Plokkke/sauter-marapi-esphome/hardware/linap/radiator-controller-linap-3d.png

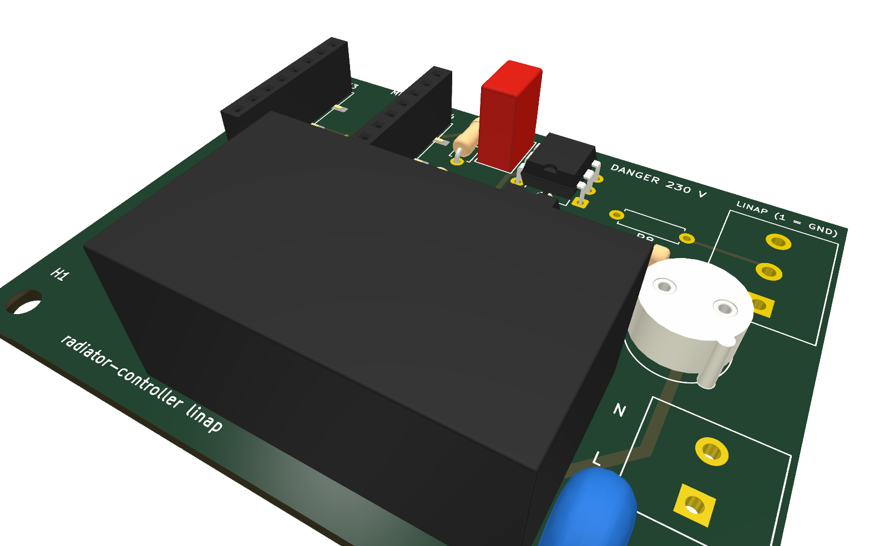
hardware/linap/radiator-controller-linap-3d.png
