Plokkke/sauter-marapi-esphome/hardware/linap/radiator-controller-linap-bottom.png

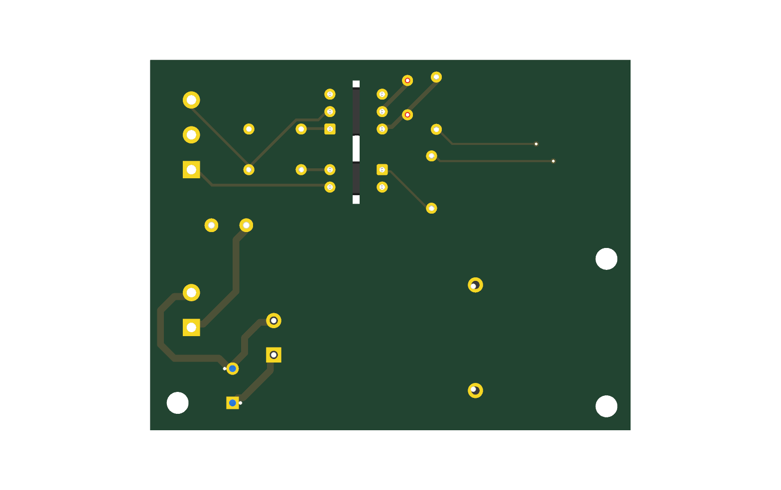
hardware/linap/radiator-controller-linap-bottom.png
