Plokkke/sauter-marapi-esphome/hardware/linap/radiator-controller-linap-top.png

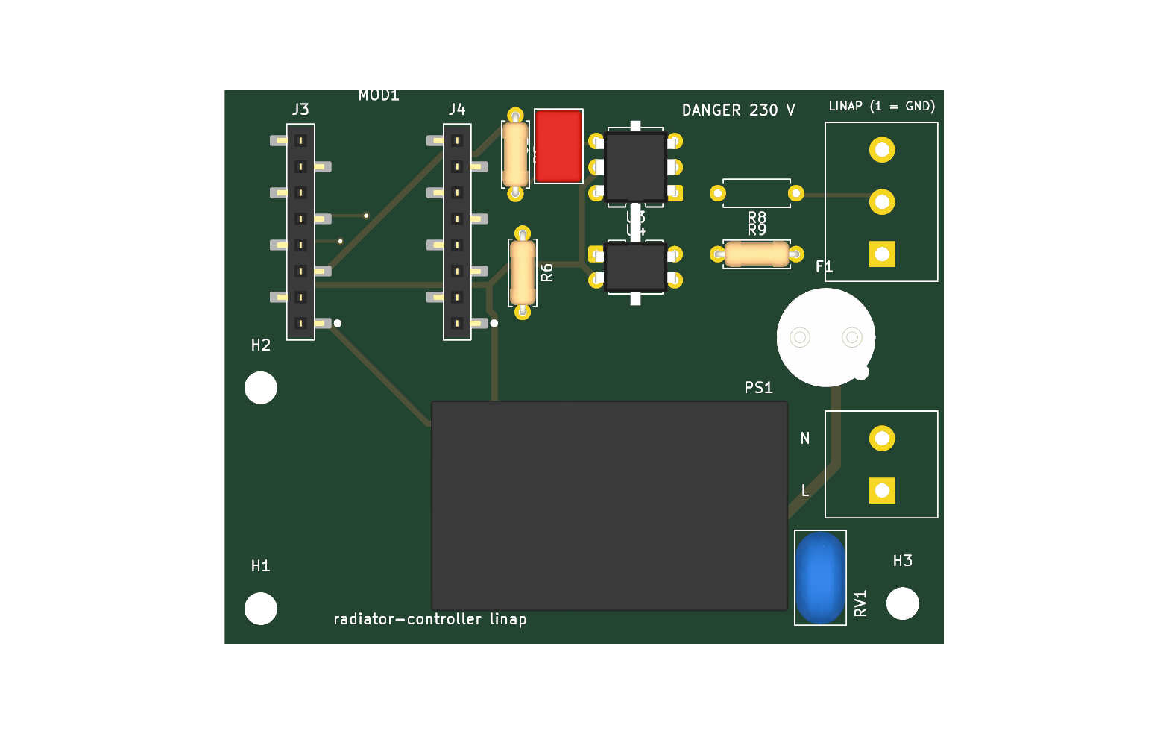
hardware/linap/radiator-controller-linap-top.png
