Plokkke/sauter-marapi-esphome/hardware/radiator-controller-bottom.png

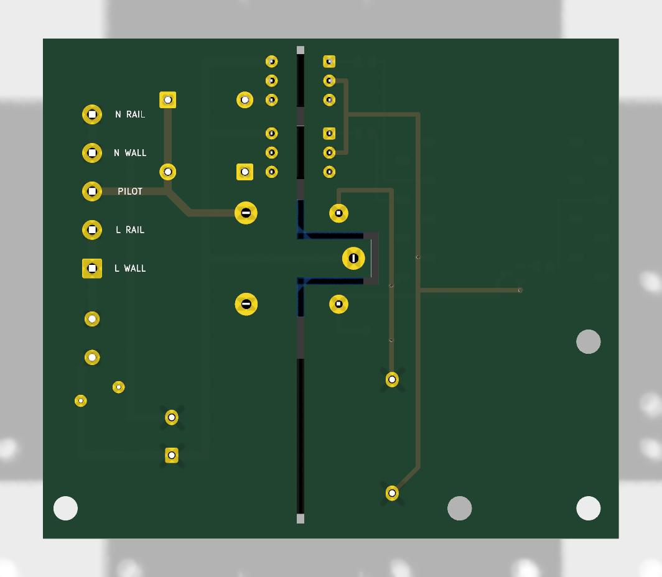
hardware/radiator-controller-bottom.png
