Plokkke/sauter-marapi-esphome/hardware/radiator-controller-top.png

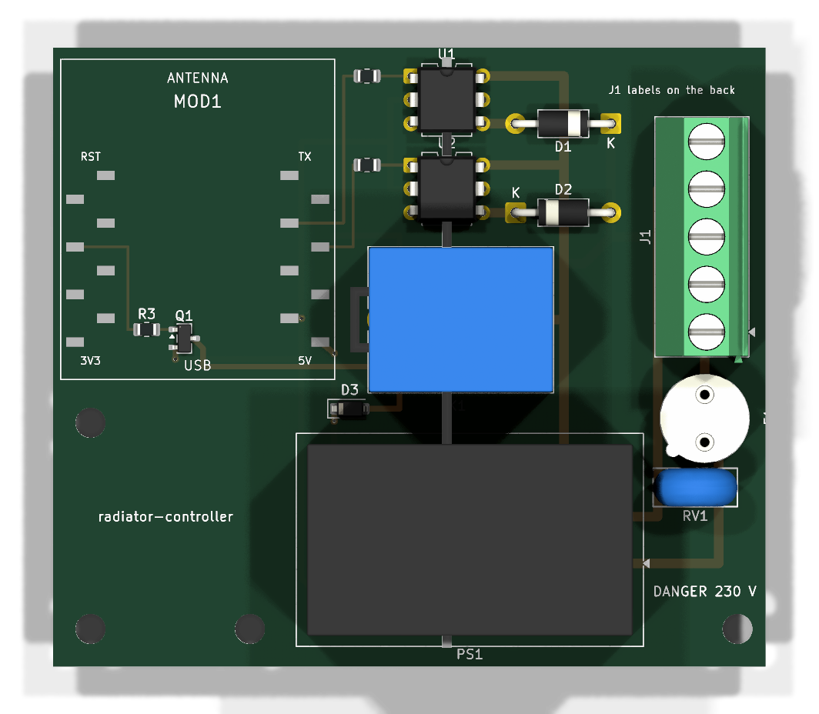
hardware/radiator-controller-top.png
