Plokkke/sauter-marapi-esphome/knowledge/photos/command-board-keys.jpg

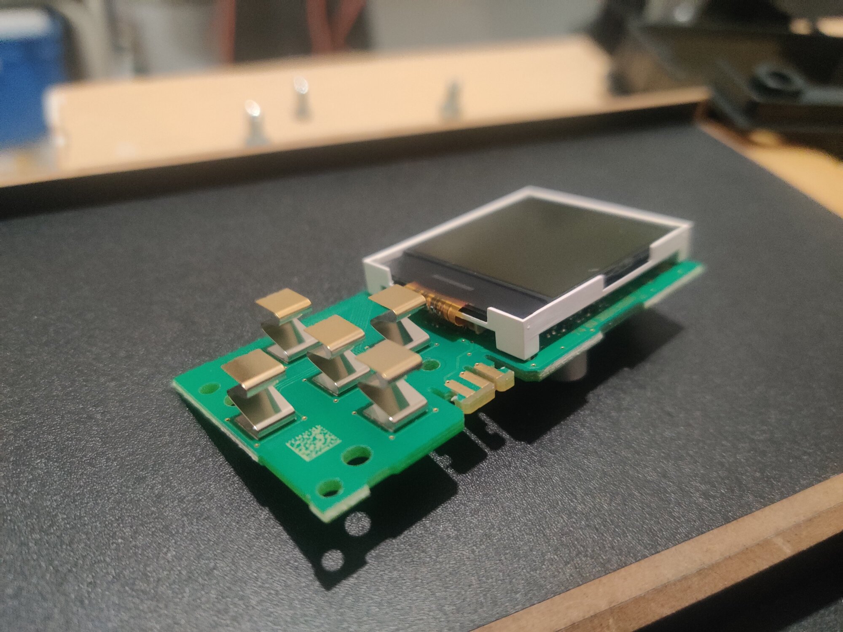
knowledge/photos/command-board-keys.jpg
