Plokkke/sauter-marapi-esphome/hardware/linap/radiator-controller-linap.step

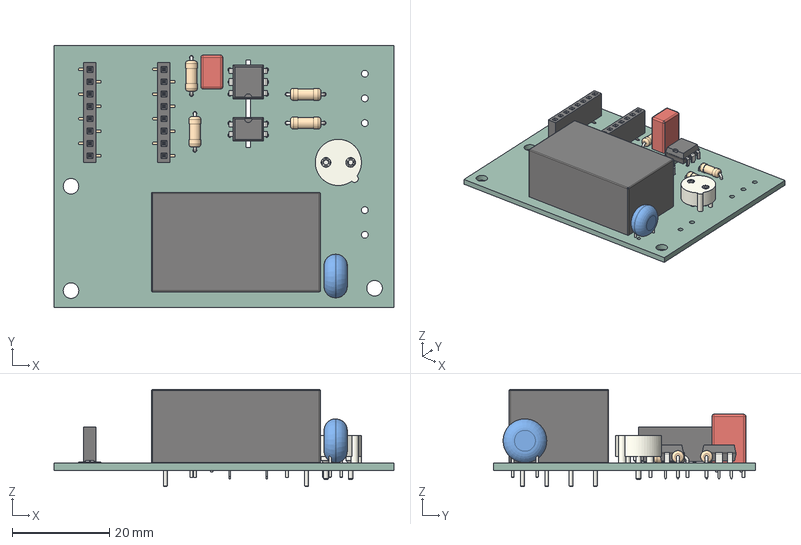
[picture p11: CAD file, 2026-11-09]
hardware/linap/radiator-controller-linap.step
70.0 x 54.0 x 20.0 mm
C_Rect_L70mm_W45mm_P500mm
PinSocket_1x08_P2.54mm_Vertical_SMD_Pin1Left x 2
R_Axial_DIN0207_L63mm_D25mm_P762mm_Horizontal x 4
RV_Disc_D9mm_W48mm_P5mm
Converter_ACDC_Hi-Link_HLK-PMxx
DIP-4_W7.62mm
A_Littelfuse_No560_No460
DIP-6_W7.62mm
radiator-controller-linap_PCB
