Plokkke/sauter-marapi-esphome/hardware/pilot-wire/radiator-controller-pilot-wire.step

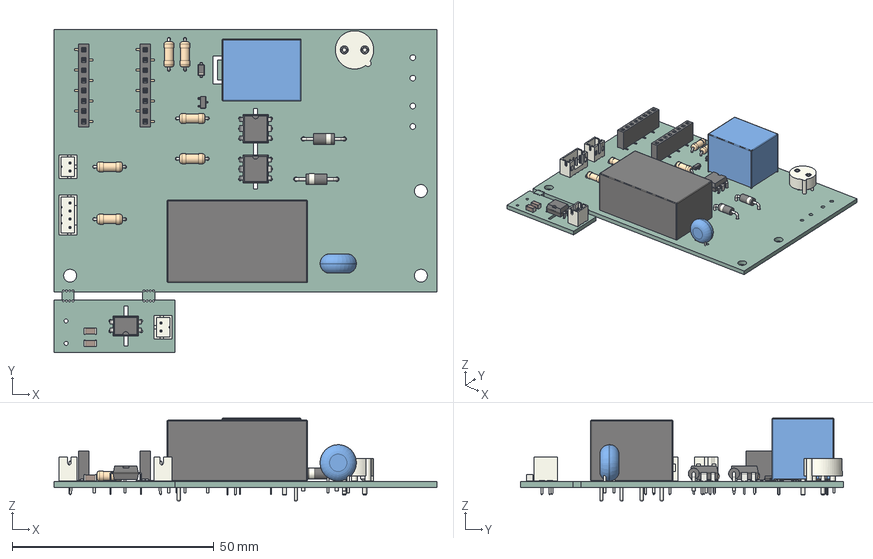
[picture p12: CAD file, 2026-11-09]
hardware/pilot-wire/radiator-controller-pilot-wire.step
95.0 x 80.0 x 20.5 mm
R_Axial_DIN0207_L63mm_D25mm_P762mm_Horizontal x 6
DIP-6_W7.62mm x 2
RV_Disc_D9mm_W48mm_P5mm
D_DO-41_SOD81_P10.16mm_Horizontal x 2
JST_B2B_PH_K x 2
PinSocket_1x08_P2.54mm_Vertical_SMD_Pin1Left x 2
JST_B4B_PH_K
Converter_ACDC_Hi-Link_HLK-PMxx
D_SOD-123
C_1206_3216Metric x 2
A_Littelfuse_No560_No460
SOT-23
Relay_SPDT_SANYOU_SRD_Series_Form_C
DIP-4_W7.62mm
radiator-controller-pilot-wire_PCB
