Plokkke/sauter-marapi-esphome/hardware/radiator-controller.step

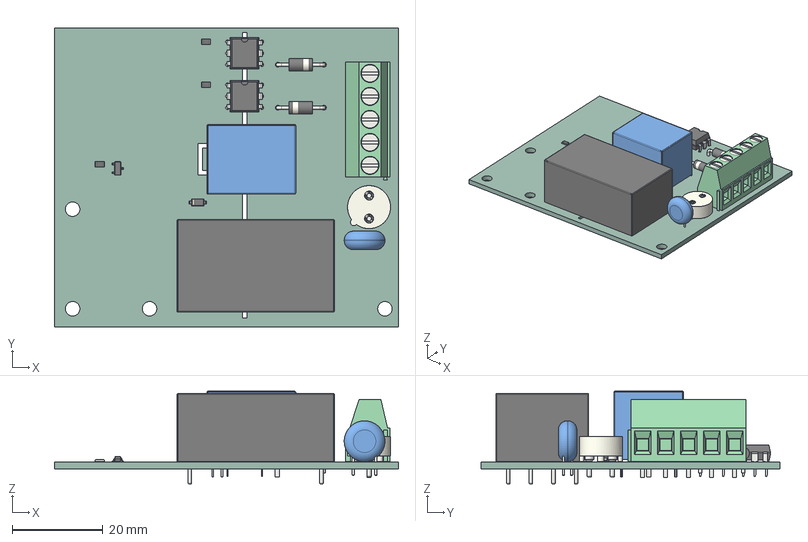
[picture p13: CAD file, 2026-10-26]
hardware/radiator-controller.step
76.0 x 66.0 x 20.5 mm
D_DO-41_SOD81_P10.16mm_Horizontal x 2
R_0805_2012Metric x 3
A_Littelfuse_No560_No460
D_SOD-123
Relay_SPDT_SANYOU_SRD_Series_Form_C
DIP-6_W7.62mm x 2
SOT-23
RV_Disc_D9mm_W41mm_P5mm
TerminalBlock_Phoenix_MKDS-1,5-5-5.08_1x05_P5.08mm_Horizontal
Converter_ACDC_Hi-Link_HLK-PMxx
radiator-controller_PCB
