Plokkke/sauter-marapi-esphome/hardware/pilot-wire/radiator-controller-pilot-wire.kicad_pcb

## KiCad design hardware/pilot-wire/radiator-controller-pilot-wire.kicad_pcb (2026-11-09)

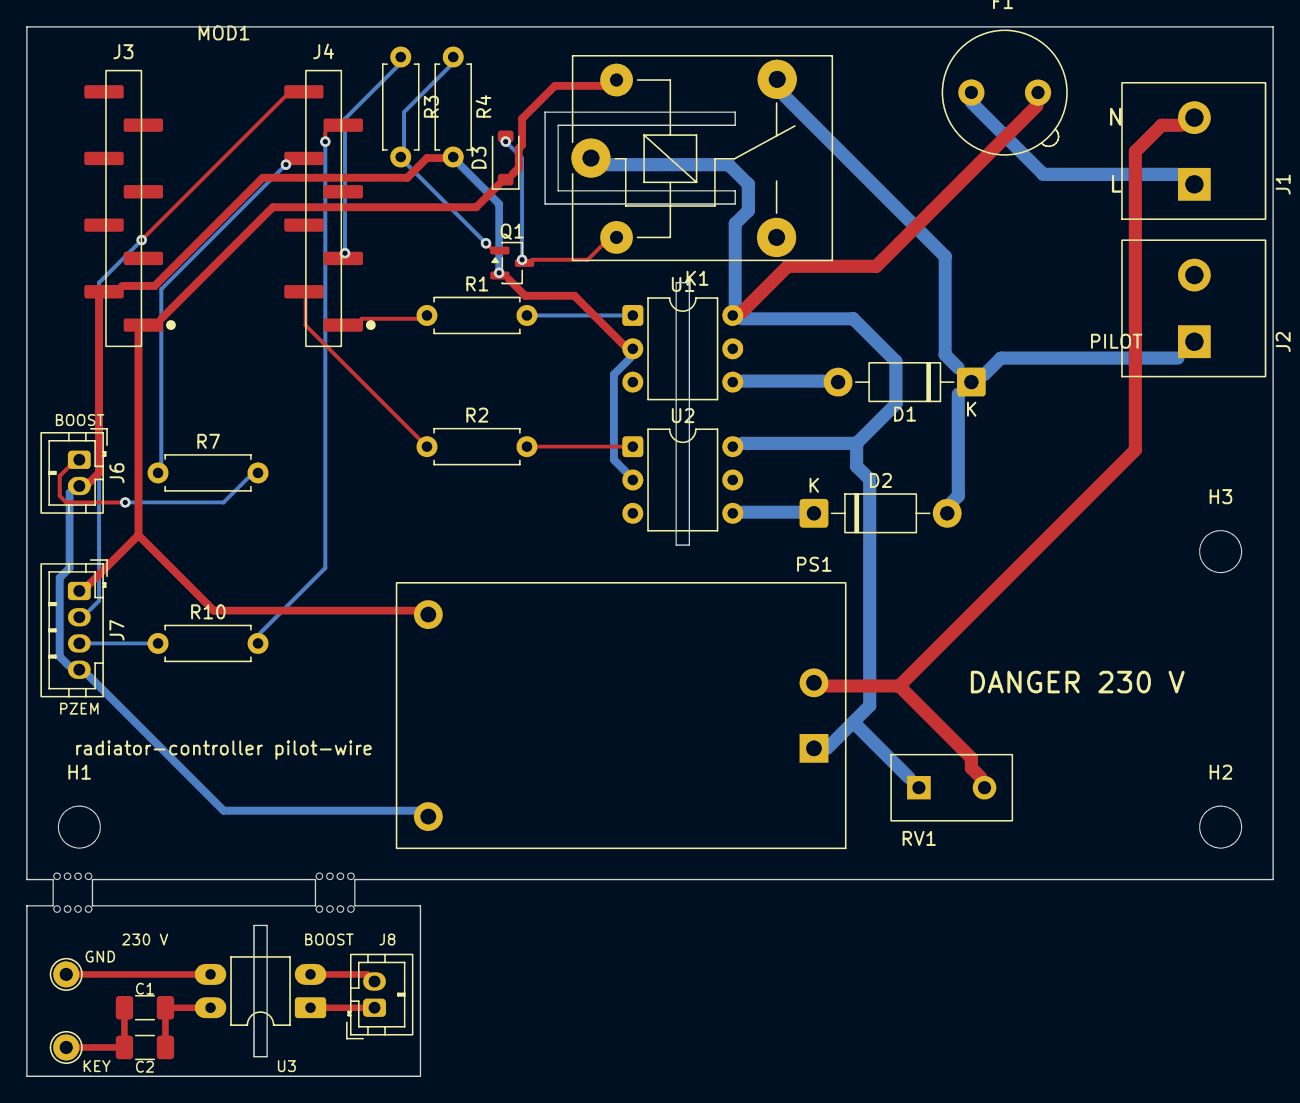
[picture p14: board radiator-controller-pilot-wire.kicad_pcb from above]

Board: 2 copper layers, 95.0 x 80.0 mm, 34 parts (0 on the bottom side), 25 nets.

Parts:
C1, C2: 10-100p C0G; C_1206_3216Metric_Pad1.33x1.80mm_HandSolder
D1, D2: 1N4007; D_DO-41_SOD81_P10.16mm_Horizontal
D3: 1N4148W; D_SOD-123
F1: TR5 holder + T1A fuse; Fuseholder_TR5_Littelfuse_No560_No460
H1, H2, H3: MountingHole_3.2mm_M3
J1: KF128-5.08 (L, N); TerminalBlock_Kefa_KF128-5.08_1x02
J2: KF128-5.08 (pilot wire); TerminalBlock_Kefa_KF128-5.08_1x02
J3, J4: Socket 1x8 SMD; PinSocket_1x08_P2.54mm_SMD_HX-ZQ
J6: JST PH 2 (Boost photoMOS LED); JST_PH_B2B-PH-K_1x02_P2.00mm_Vertical_Drill0.9
J7: JST PH 4 (PZEM-004T v3: 5V RX TX GND); JST_PH_B4B-PH-K_1x04_P2.00mm_Vertical_Drill0.9
J8: JST PH 2 (from J6); JST_PH_B2B-PH-K_1x02_P2.00mm_Vertical_Drill0.9
K1: SRD-05VDC-SL-C; Relay_SPDT_SANYOU_SRD_Series_Form_C
MB1, MB2: Breakaway_MouseBites_3mm
MOD1: ESP32-C3 super mini; ESP32-C3_SuperMini_Outline
PS1: HLK-PM01; Converter_ACDC_HLK-PM01
Q1: MMBT2222A; SOT-23
R1, R2, R7: 220; R_Axial_DIN0207_L6.3mm_D2.5mm_P7.62mm_Horizontal
R3, R10: 1k; R_Axial_DIN0207_L6.3mm_D2.5mm_P7.62mm_Horizontal
R4: 10k; R_Axial_DIN0207_L6.3mm_D2.5mm_P7.62mm_Horizontal
RV1: MOV-07D431K (275VAC); RV_Disc_D9mm_W4.8mm_P5mm_Inline
TP1: KEY; TestPoint_THTPad_D2.0mm_Drill1.0mm
TP2: CTRL GND; TestPoint_THTPad_D2.0mm_Drill1.0mm
U1, U2: MOC3043M; DIP-6_W7.62mm
U3: photoMOS; DIP-4_W7.62mm_LongPads

Connections:
+5V: D3.1, J3.1, J7.1, K1.5, PS1.4
/GPIO5: J4.1, R1.1
/GPIO6: J4.2, R2.1
/GPIO7: J4.3, R3.1
/GPIO10: J4.6, R7.1
/GPIO20: J4.7, R10.2
/GPIO21: J4.8, J7.2
/KEY: C1.2, C2.2, TP1.1
/KEY_SW: C1.1, C2.1, U3.4
/L: F1.1, J1.1
/LINAP_GND: TP2.1, U3.3
/L_FUSED: F1.2, K1.1, PS1.1, RV1.1, U1.6, U2.6
/N: J1.2, PS1.2, RV1.2
/PILOT_WIRE: D1.1, D2.2, J2.1, K1.4
/U1_OUT: D1.2, U1.4
/U2_OUT: D2.1, U2.4
GND: J3.2, J6.2, J7.4, PS1.3, Q1.2, R4.2, U1.2, U2.2
unnamed: D3.2, K1.2, Q1.3
unnamed: J6.1, R7.2
unnamed: J7.3, R10.1
unnamed: J8.1, U3.1
unnamed: J8.2, U3.2
unnamed: Q1.1, R3.2, R4.1
unnamed: R1.2, U1.1
unnamed: R2.2, U2.1
