Plokkke/sauter-marapi-esphome/hardware/linap/radiator-controller-linap.kicad_pcb

## KiCad design hardware/linap/radiator-controller-linap.kicad_pcb (2026-11-09)

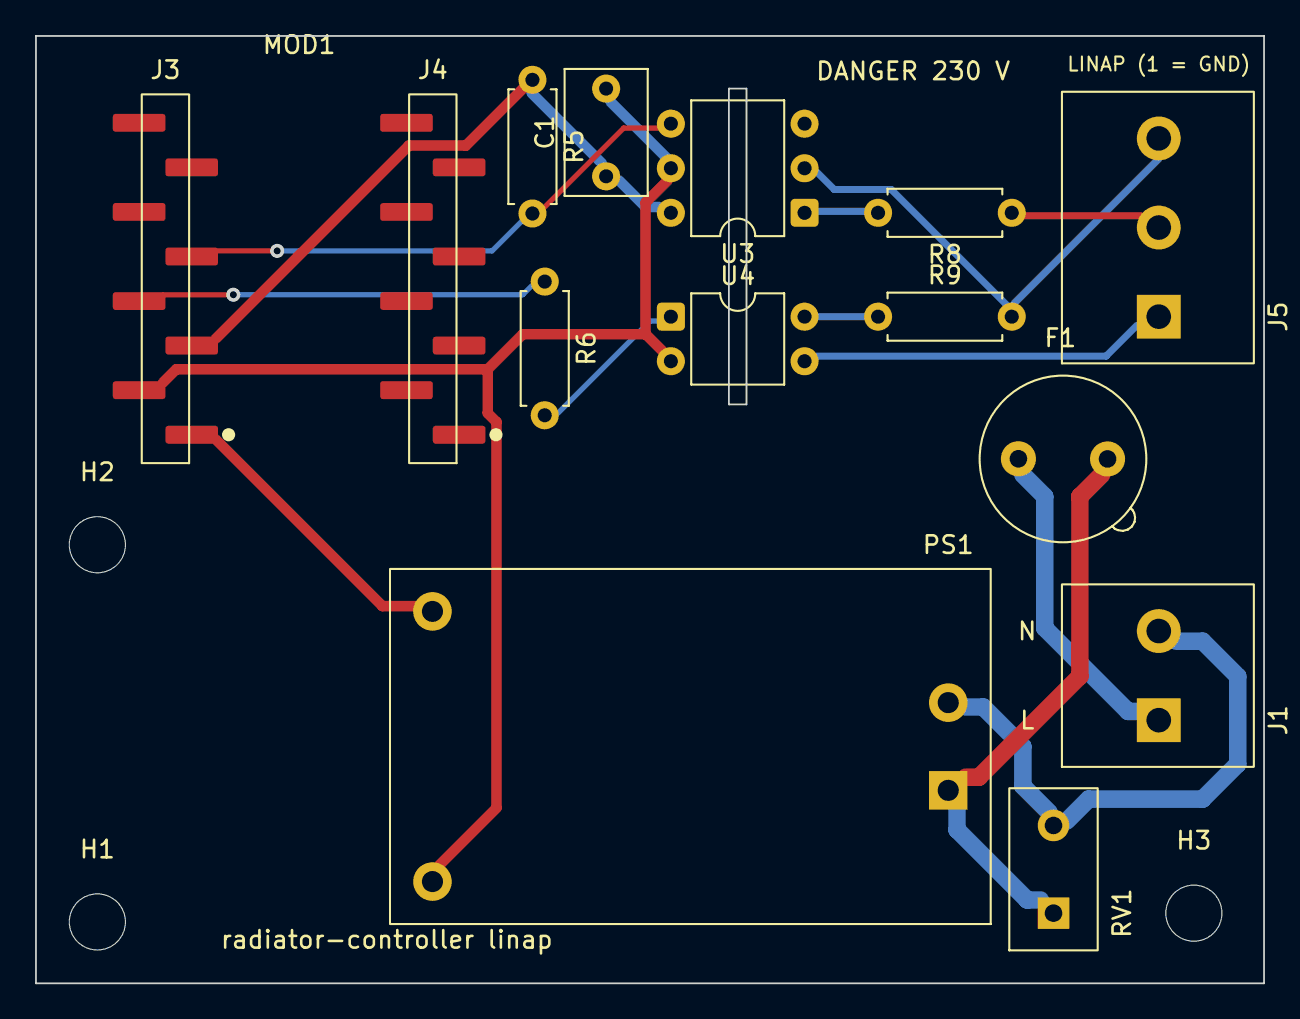
[picture p15: board radiator-controller-linap.kicad_pcb from above]

Board: 2 copper layers, 70.0 x 54.0 mm, 18 parts (0 on the bottom side), 14 nets.

Parts:
C1: 100n; C_Rect_L7.0mm_W4.5mm_P5.00mm
F1: TR5 holder + T1A fuse; Fuseholder_TR5_Littelfuse_No560_No460
H1, H2, H3: MountingHole_3.2mm_M3
J1: KF128-5.08 (L, N); TerminalBlock_Kefa_KF128-5.08_1x02
J3, J4: Socket 1x8 SMD; PinSocket_1x08_P2.54mm_SMD_HX-ZQ
J5: KF128-5.08 (Linap GND, VCC, DATA); TerminalBlock_Kefa_KF128-5.08_1x03
MOD1: ESP32-C3 super mini; ESP32-C3_SuperMini_Outline
PS1: HLK-PM01; Converter_ACDC_HLK-PM01
R5: 1k; R_Axial_DIN0207_L6.3mm_D2.5mm_P7.62mm_Horizontal
R6: 220; R_Axial_DIN0207_L6.3mm_D2.5mm_P7.62mm_Horizontal
R8: TBD; R_Axial_DIN0207_L6.3mm_D2.5mm_P7.62mm_Horizontal
R9: 100; R_Axial_DIN0207_L6.3mm_D2.5mm_P7.62mm_Horizontal
RV1: MOV-07D431K (275VAC); RV_Disc_D9mm_W4.8mm_P5mm_Inline
U3: H11L1M; DIP-6_W7.62mm
U4: LTV-817; DIP-4_W7.62mm

Connections:
+3V3: C1.1, J3.3, R5.1, U3.6
+5V: J3.1, PS1.4
/GPIO3: J3.5, R5.2, U3.4
/GPIO4: J3.4, R6.1
/L: F1.1, J1.1
/LINAP_DATA: J5.3, R9.2, U3.2
/LINAP_GND: J5.1, U4.3
/LINAP_LED: R8.2, U3.1
/LINAP_TX: R9.1, U4.4
/LINAP_VCC: J5.2, R8.1
/L_FUSED: F1.2, PS1.1, RV1.1
/N: J1.2, PS1.2, RV1.2
GND: C1.2, J3.2, PS1.3, U3.5, U4.2
unnamed: R6.2, U4.1
