Plokkke/sauter-marapi-esphome/hardware/radiator-controller.kicad_pcb

## KiCad design hardware/radiator-controller.kicad_pcb (2026-10-26)

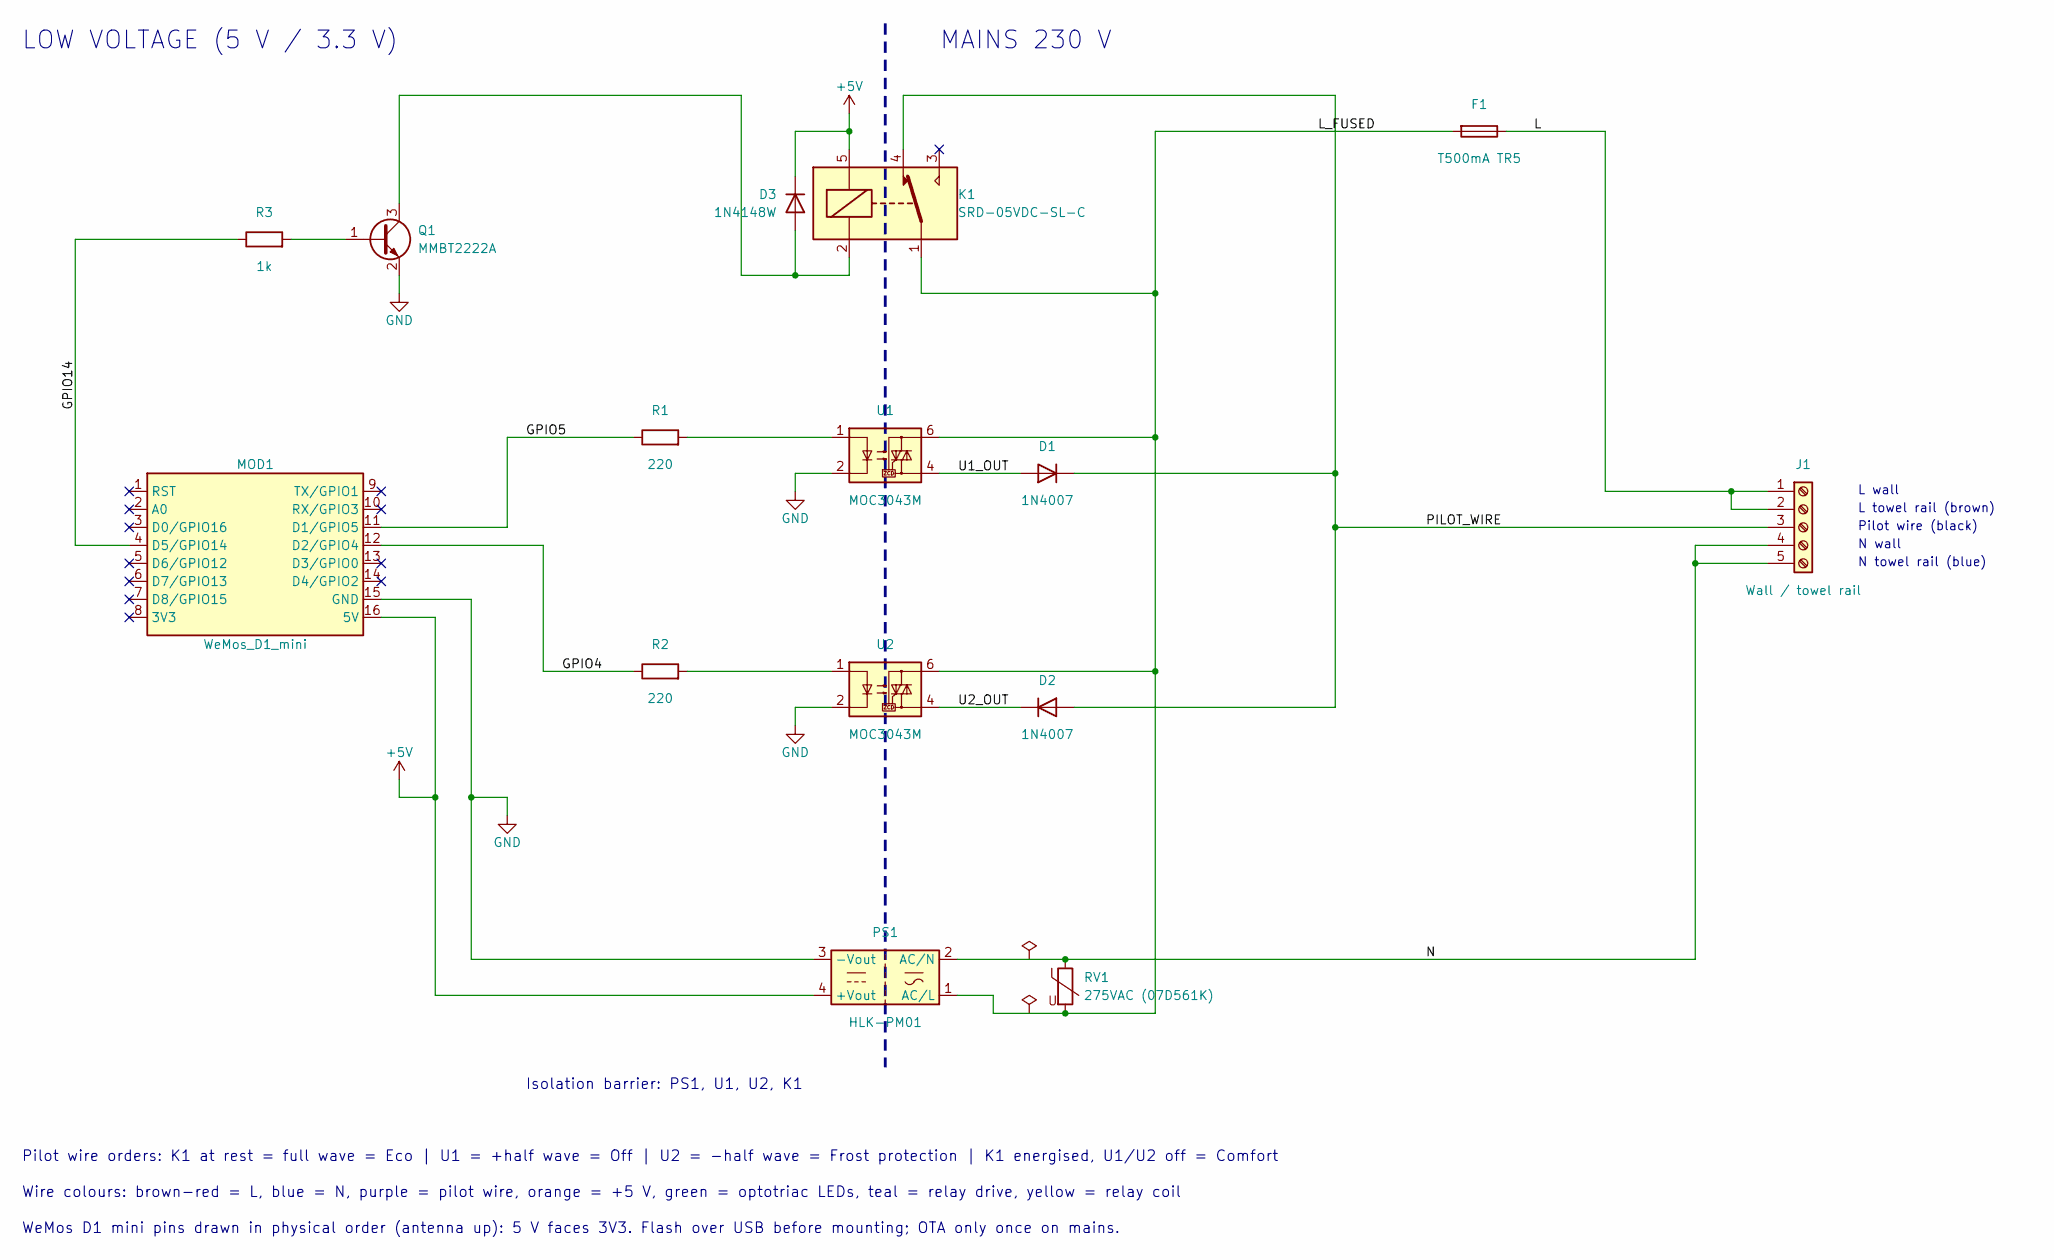
[picture p16: schematic radiator-controller.kicad_sch, Radiator controller - fil pilote 6 ordres]

Parts:
D1, D2: 1N4007; D_DO-41_SOD81_P10.16mm_Horizontal
D3: 1N4148W; D_SOD-123
F1: T500mA TR5; Fuseholder_TR5_Littelfuse_No560_No460
J1: Wall / towel rail; TerminalBlock_Phoenix_MKDS-1,5-5-5.08_1x05_P5.08mm_Horizont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
K1: SRD-05VDC-SL-C; Relay_SPDT_SANYOU_SRD_Series_Form_C
MOD1: WeMos_D1_mini; WEMOS_D1_mini_SMD_sockets
PS1: HLK-PM01; Converter_ACDC_Hi-Link_HLK-PMxx
Q1: MMBT2222A; SOT-23
R1, R2: 220; R_0805_2012Metric
R3: 1k; R_0805_2012Metric
RV1: 275VAC (07D561K); RV_Disc_D9mm_W4.1mm_P5mm
U1, U2: MOC3043M; DIP-6_W7.62mm

Connections:
+5V: D3.1 (K), K1.5, MOD1.16 (5V), PS1.4 (+Vout)
/GPIO4: MOD1.12 (D2/GPIO4), R2.1
/GPIO5: MOD1.11 (D1/GPIO5), R1.1
/GPIO14: MOD1.4 (D5/GPIO14), R3.1
/L: F1.1, J1.1, J1.2
/L_FUSED: F1.2, K1.1, PS1.1 (AC/L), RV1.2, U1.6, U2.6
/N: J1.4, J1.5, PS1.2 (AC/N), RV1.1
/PILOT_WIRE: D1.1 (K), D2.2 (A), J1.3, K1.4
/U1_OUT: D1.2 (A), U1.4
/U2_OUT: D2.1 (K), U2.4
GND: MOD1.15 (GND), PS1.3 (-Vout), Q1.2 (E), U1.2, U2.2
unnamed: D3.2 (A), K1.2, Q1.3 (C)
unnamed: Q1.1 (B), R3.2
unnamed: R1.2, U1.1
unnamed: R2.2, U2.1

Notes on the sheet:
LOW VOLTAGE (5 V / 3.3 V)
MAINS 230 V
Isolation barrier: PS1, U1, U2, K1
Pilot wire orders: K1 at rest = full wave = Eco | U1 = +half wave = Off | U2 = -half wave = Frost protection | K1 energised, U1/U2 off = Comfort
Wire colours: brown-red = L, blue = N, purple = pilot wire, orange = +5 V, green = optotriac LEDs, teal = relay drive, yellow = relay coil
WeMos D1 mini pins drawn in physical order (antenna up): 5 V faces 3V3. Flash over USB before mounting; OTA only once on mains.
L wall
L towel rail (brown)
Pilot wire (black)
N wall
N towel rail (blue)

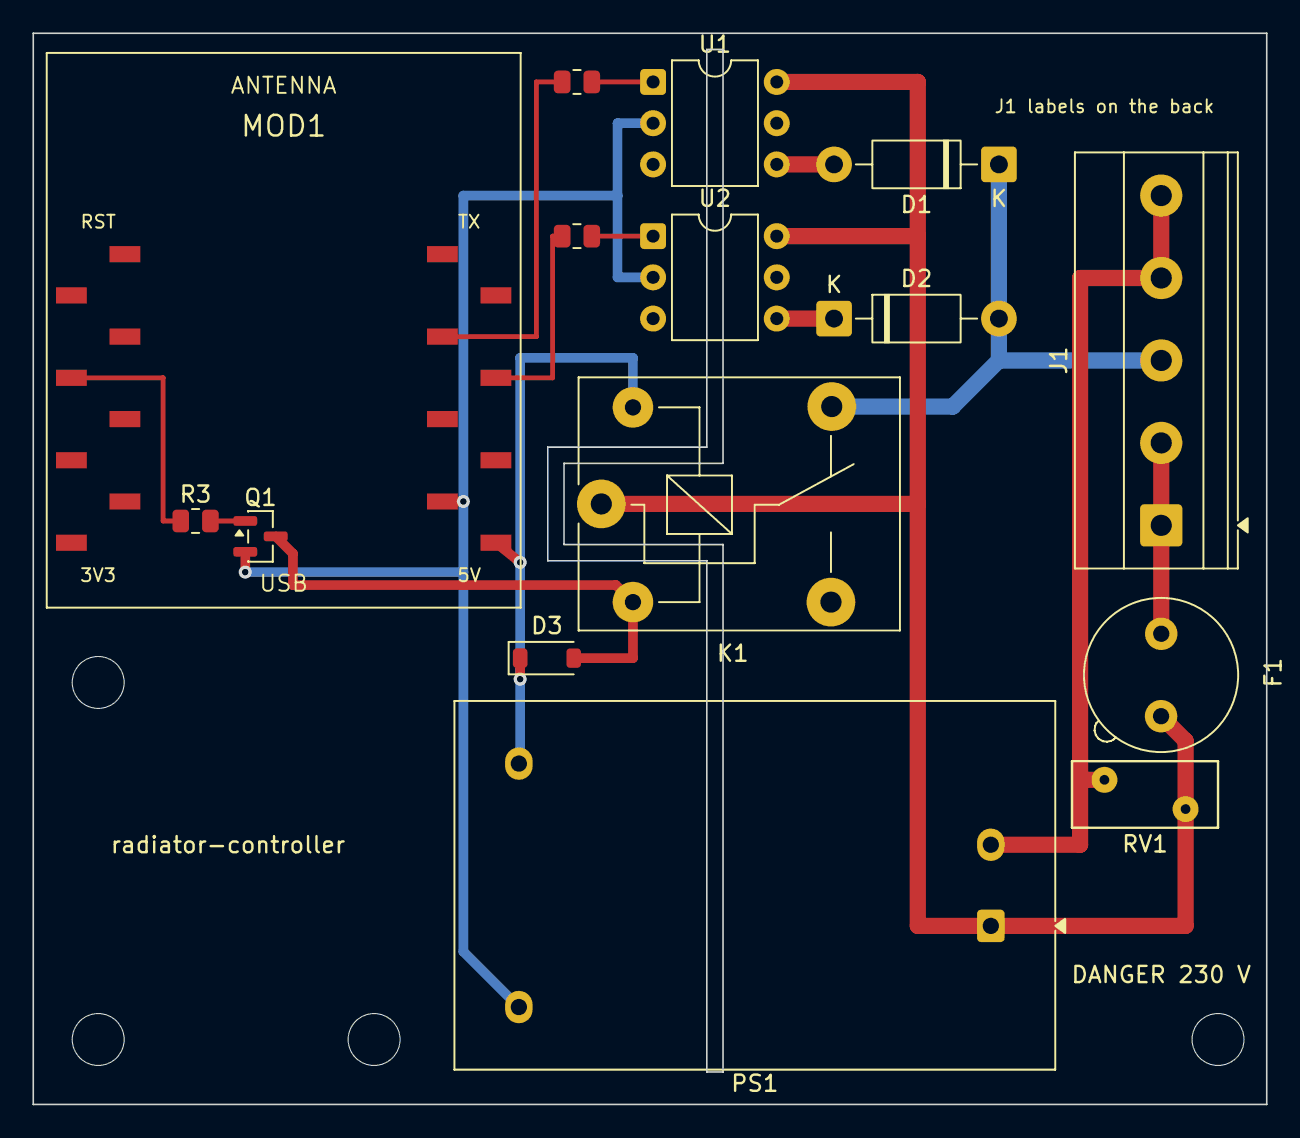
[picture p17: board radiator-controller.kicad_pcb from above]

Board: 2 copper layers, 76.0 x 66.0 mm, 19 parts (0 on the bottom side), 15 nets.

Other parts of the board:
H1, H2, H3, H4: MountingHole_3.2mm_M3
