Plokkke/sauter-marapi-esphome/firmware/mitm/src/home_assistant.rs

//! Home Assistant side: one MQTT device discovery message, the state it reads, the commands it sends.
use alloc::format;
use alloc::string::String;
use core::net::SocketAddrV4;
use core::str::FromStr;

use linap::{Mode, PowerState, Setpoint, parse_halves};

use crate::bus::{Heard, Side, Snapshot};

macro_rules! topic {
    ($name:literal) => {
        concat!("sauter-marapi/", $name)
    };
}

/// One discovery component, reading its value from the shared state topic.
macro_rules! component {
    ($id:literal, $($fields:expr),+) => {
        concat!(
            "\"", $id, "\":{", $($fields),+, ",\"val_tpl\":\"{{ value_json.", $id, " }}\",\"uniq_id\":\"sauter_marapi_", $id, "\"}"
        )
    };
}

pub const AVAILABILITY: &str = topic!("availability");
/// Retained, so that Home Assistant has it as soon as it subscribes (after a restart, or a new discovery).
pub const STATE: &str = topic!("state");
pub const COMMANDS: &str = topic!("+/set");
/// Frames heard on the bus, when the frame log is on: one line each, for the analysis of the unknown frames.
pub const FRAMES: &str = topic!("frames");
pub const DISCOVERY: &str = "homeassistant/device/sauter_marapi/config";
const MODE: &str = topic!("mode/set");
const SETPOINT: &str = topic!("setpoint/set");
const REPLY_GAP: &str = topic!("reply-gap/set");
const BOOST_DURATION: &str = topic!("boost-duration/set");
const FRAME_LOG: &str = topic!("frame-log/set");
const NOTE: &str = topic!("note/set");
/// "192.168.1.10:40123": where `firmware/tools/ota.py` serves the new image (not a Home Assistant entity).
const OTA: &str = topic!("ota/set");
const MINUTE_US: u64 = 60_000_000;
const MAX_BOOST_MINUTES: u8 = 120;

/// The configuration entities are retained by the broker: it hands them back after a restart of the board.
pub const DISCOVERY_PAYLOAD: &str = concat!(
    "{\"dev\":{\"ids\":[\"sauter_marapi\"],\"name\":\"Sauter Marapi\",\"mf\":\"Sauter\",\"mdl\":\"Marapi tactile\"},",
    "\"o\":{\"name\":\"sauter-marapi-mitm\"},",
    "\"avty_t\":\"",
    topic!("availability"),
    "\",\"stat_t\":\"",
    topic!("state"),
    "\",\"cmps\":{",
    component!(
        "power",
        "\"p\":\"sensor\",\"name\":\"Power board\",\"dev_cla\":\"enum\",\"ops\":[\"idle\",\"heating\",\"boost\",\"boost_ending\",\"off\",\"unknown\"]"
    ),
    ",",
    component!("heating", "\"p\":\"binary_sensor\",\"name\":\"Heating\",\"dev_cla\":\"heat\""),
    ",",
    component!(
        "mode",
        "\"p\":\"select\",\"name\":\"Mode\",\"ops\":[\"off\",\"on\",\"boost\"],\"cmd_t\":\"",
        topic!("mode/set"),
        "\""
    ),
    ",",
    component!(
        "setpoint",
        "\"p\":\"number\",\"name\":\"Setpoint\",\"dev_cla\":\"temperature\",\"unit_of_meas\":\"°C\",\"min\":5,\"max\":30,\"step\":0.5,\"mode\":\"box\",\"cmd_t\":\"",
        topic!("setpoint/set"),
        "\""
    ),
    ",",
    component!(
        "boost_duration",
        "\"p\":\"number\",\"name\":\"Boost duration\",\"ent_cat\":\"config\",\"ret\":true,\"dev_cla\":\"duration\",\"unit_of_meas\":\"min\",\"min\":1,\"max\":120,\"step\":1,\"mode\":\"box\",\"cmd_t\":\"",
        topic!("boost-duration/set"),
        "\""
    ),
    ",",
    component!(
        "reply_gap",
        "\"p\":\"number\",\"name\":\"Reply gap\",\"ent_cat\":\"config\",\"ret\":true,\"unit_of_meas\":\"bits\",\"min\":0,\"max\":30,\"step\":0.5,\"mode\":\"box\",\"cmd_t\":\"",
        topic!("reply-gap/set"),
        "\""
    ),
    ",",
    component!(
        "frame_log",
        "\"p\":\"switch\",\"name\":\"Frame log\",\"ent_cat\":\"config\",\"ret\":true,\"cmd_t\":\"",
        topic!("frame-log/set"),
        "\""
    ),
    ",",
    component!(
        "note",
        "\"p\":\"text\",\"name\":\"Note\",\"ent_cat\":\"diagnostic\",\"max\":100,\"cmd_t\":\"",
        topic!("note/set"),
        "\""
    ),
    ",",
    component!(
        "rssi",
        "\"p\":\"sensor\",\"name\":\"Wi-Fi signal\",\"ent_cat\":\"diagnostic\",\"dev_cla\":\"signal_strength\",\"unit_of_meas\":\"dBm\",\"stat_cla\":\"measurement\""
    ),
    ",",
    component!(
        "answered",
        "\"p\":\"sensor\",\"name\":\"Polls answered\",\"ent_cat\":\"diagnostic\",\"unit_of_meas\":\"%\",\"stat_cla\":\"measurement\""
    ),
    "}}"
);

pub enum Command<'p> {
    Mode(Mode),
    Setpoint(Setpoint),
    ReplyGap(u32),
    /// How long an imposed Boost lasts, in microseconds.
    BoostDuration(u64),
    FrameLog(bool),
    /// A marker written in the frame log, between the frames it follows and the ones that follow it.
    Note(&'p str),
    /// Fetch the new image from this address and boot it.
    Ota(SocketAddrV4),
}

pub fn parse_command<'p>(topic: &str, payload: &'p str) -> Option<Command<'p>> {
    match topic {
        MODE => parse_mode(payload).map(Command::Mode),
        SETPOINT => Setpoint::parse(payload).map(Command::Setpoint),
        REPLY_GAP => parse_halves(payload).map(|halves| Command::ReplyGap(halves.into())),
        BOOST_DURATION => parse_halves(payload)
            .map(|halves| halves / 2)
            .filter(|minutes| (1..=MAX_BOOST_MINUTES).contains(minutes))
            .map(|minutes| Command::BoostDuration(u64::from(minutes) * MINUTE_US)),
        FRAME_LOG => match payload {
            "ON" => Some(Command::FrameLog(true)),
            "OFF" => Some(Command::FrameLog(false)),
            _ => None,
        },
        NOTE => Some(Command::Note(payload)),
        OTA => SocketAddrV4::from_str(payload.trim()).ok().map(Command::Ota),
        _ => None,
    }
}

/// The JSON of the state topic; unknown values are null, which Home Assistant shows as unknown.
/// The note is always empty: Home Assistant clears its field once the note is in the log.
pub fn state_json(bus: &Snapshot, reply_gap_half_bits: u32, answered: Option<u32>, rssi: Option<i32>) -> String {
    format!(
        "{{\"power\":{},\"heating\":{},\"mode\":\"{}\",\"setpoint\":{},\"boost_duration\":{},\"reply_gap\":{}.{},\"answered\":{},\"frame_log\":\"{}\",\"note\":\"\",\"rssi\":{}}}",
        quoted(bus.power.map(PowerState::name)),
        quoted(bus.power.map(|power| if power.is_heating() { "ON" } else { "OFF" })),
        mode_name(bus.mode),
        bus.setpoint,
        bus.boost_us / MINUTE_US,
        reply_gap_half_bits / 2,
        if reply_gap_half_bits % 2 == 1 { 5 } else { 0 },
        answered.map_or(String::from("null"), |percent| format!("{percent}")),
        if bus.frame_log { "ON" } else { "OFF" },
        rssi.map_or(String::from("null"), |rssi| format!("{rssi}")),
    )
}

/// "12.345 P C7 80 E0 38 58": seconds since boot, half of DATA (P power board, C command board), frame.
pub fn frame_line(heard: &Heard) -> String {
    let side = match heard.side {
        Side::Power => 'P',
        Side::Command => 'C',
    };
    format!("{} {side} {}", seconds(heard.at_us), heard.frame)
}

/// The MQTT topic of a command, from its short name (`mode`, `setpoint`…).
pub fn command_topic(name: &str) -> String {
    format!("{}{name}/set", topic!(""))
}

pub fn note_line(at_us: u64, note: &str) -> String {
    format!("{} note {note}", seconds(at_us))
}

fn seconds(at_us: u64) -> String {
    format!("{}.{:03}", at_us / 1_000_000, at_us / 1_000 % 1_000)
}

fn quoted(text: Option<&str>) -> String {
    text.map_or(String::from("null"), |text| format!("\"{text}\""))
}

/// The mode and setpoint of a state published before (retained by the broker); the mode defaults to on, in a
/// state published by an older firmware.
pub fn saved_state(json: &str) -> Option<(Mode, Setpoint)> {
    let mode = field(json, "mode").map_or(Some(Mode::On), |mode| parse_mode(mode.trim_matches('"')))?;
    Some((mode, Setpoint::parse(field(json, "setpoint")?)?))
}

fn field<'j>(json: &'j str, name: &str) -> Option<&'j str> {
    let start = json.find(&format!("\"{name}\":"))? + name.len() + 3;
    let value = &json[start..];
    value.find([',', '}']).map(|end| &value[..end])
}

fn parse_mode(text: &str) -> Option<Mode> {
    match text {
        "off" => Some(Mode::Off),
        "on" => Some(Mode::On),
        "boost" => Some(Mode::Boost),
        _ => None,
    }
}

fn mode_name(mode: Mode) -> &'static str {
    match mode {
        Mode::Off => "off",
        Mode::On => "on",
        Mode::Boost => "boost",
    }
}
