Plokkke/sauter-marapi-esphome/(commit log)

2026-10-26 chore: ignore ESPHome secrets and KiCad local files
2026-10-26 docs(knowledge): document pilot wire study and control board findings
    - 6-order pilot wire signals, Sauter Marapi tactile manual, schematic
    walkthrough and BOM
    - architecture decisions: Eco failsafe, power from the wall supply
    - backlog with the boost and Linap reverse engineering leads
2026-10-26 feat(firmware): add ESPHome pilot wire controller
    Expose the 6 pilot wire orders as a Home Assistant select, drive two
    optotriacs and an NC relay, and fall back to Eco after 30 min without
    Home Assistant.
2026-10-26 feat(hardware): add KiCad schematic and PCB
    Wired schematic with hop-overs, 76 x 66 mm two-layer board with a 230 V
    isolation slot, custom clearance and creepage DRC rules, renders and a
    STEP model for enclosure design.
2026-11-08 feat(discovery): add Linap bus sniffer and bench schematic
    Stage 1 of the Linap reverse engineering: an ESPHome sniffer on a floating Wemos D1 mini, driven over Wi-Fi, with guided capture and a host-side decoder. One bench schematic for every stage, revision 1: divider on D2, lab supply, jumper JP1 to feed a board alone on the bench.
2026-11-08 feat(discovery): add power and command board emulators
    Stages 2 and 3: the D1 mini plays the power board against the command board alone (bench, no mains), then the command board against the power board alone. Shared transmitter package (hardware UART0 on D8, echo counter) and frame codec. Bench schematic revision 2: NPN Q1 + R6 transmit from D8, optional R7 pull-up; revisions logged in discovery/README.md.
2026-11-09 feat(hardware): move to ESP32-C3 with pilot-wire and Linap boards
    - hardware/pilot-wire: initial board (pilot wire, break-off Boost board, optional PZEM-004T)
    - hardware/linap: final board, isolated read/write of the internal Linap bus
    - hardware/lib: shared C3 super mini symbol, generated footprints, isolation DRC rules
    - export-fabrication.sh and split-bom.py: Gerbers, JLCPCB BOM/CPL and LCSC cart
    - firmware: ESP32-C3 super mini pins, network package shared with discovery/
    - knowledge: linap.md (bus findings, final board), command board photos without metadata
2026-11-09 docs(discovery): note stage 2 waits for Q1 and NPN pinouts
2026-11-10 fix(discovery): match the real Linap timing and odd parity
    - frames are sent byte by byte with the power board's idle gaps (7 bits after
    the header, then 2) or the command board's (1, then 0)
    - the power emulator follows the real 305 ms cycle: 5 slots of 61 ms, the
    command board answering in the empty ones
    - every byte carries an odd parity bit (bit 7): the setpoint is encoded with it,
    checksum_ok checks it, and the "heat demand" switch, which was that bit, is gone
    - the controller emulator answers after a reply delay set from its page (20 ms)
    - docs: parity and timing in knowledge/linap.md, stage 2 result (the command
    board never answers a fake power board), stage 3 is next
2026-11-10 feat(discovery): answer the power board's poll byte in the controller emulator
    The power board polls the command board with a lone header byte (46, or 70
    about every 30 s) after 75, C7 and 76; the command board answers one bit later
    with the 3 data bytes and the checksum only. The emulator now busy-waits for
    that byte on D2, reads it bit by bit and answers in time: the power board
    follows our setpoint, Boost and off on the radiator.
2026-11-10 feat(discovery): poll the command board from the power emulator
    The fake power board now sends the lone poll byte (46, or 70 every 30 s)
    after 75 and C7, so the command board answers it on the bench. The page can
    switch the poll off, delay it, and send another address after C7; scan.py
    drives the page to probe addresses and writes. The bus keeps the last frames
    sent, so a frame and its poll byte are both recognised as echoes.
2026-11-10 docs: rewrite the docs around the Linap man-in-the-middle
    The READMEs now follow the layout of the Viessmann project and give the
    results rather than the steps that led to them: what the board will do, the
    protocol in short, how it was decoded, and the chosen design, an ESP relaying
    between both boards with the screen left unsynchronised. The pilot wire board
    is kept as a set-aside reference, board details move to their own docs and
    to hardware/README.md, and the backlog lists what the MITM board still needs.
2026-11-10 docs: power the MITM board from the ribbon, without a fail-safe relay
    A load test on the ribbon's 5 V shows it holds about 160 mA in total and trips
    around 180 mA; a D1 mini plus the control box draw about 120 mA and survived
    radiator power-ups and Boost. The MITM board therefore moves to a ribbon-powered
    D1 mini, at mains potential like the control box, with the bench circuit on
    each channel instead of optocouplers. The fail-safe relay is dropped: a failed
    board stops the radiator in Err 10, which is safe, and it unplugs.
    The sniffer now drives D8 low: with bench revision 2, Q1 otherwise held DATA
    low and silenced the bus. Also records the C7 83 E0 38 state seen at the end
    of a Boost.
2026-11-10 chore: remove the pilot wire board
    The man-in-the-middle on the Linap bus covers everything the pilot wire board
    did, Boost included, and that board was never built. Removes its KiCad
    project, its firmware and shared config, its notes, and the footprints only it
    used; architecture.md keeps a short summary pointing back to the history.
2026-11-10 chore: clear hardware/ and keep the schematic drawing rules
    The parallel-tap Linap board (ESP32-C3, HLK-PM01, optocouplers) no longer
    matches the target, a ribbon-powered D1 mini in the middle of the bus, so the
    whole hardware/ folder goes; the history keeps it. linap.md now covers the
    protocol only. CLAUDE.md records the drawing rules shared with the Viessmann
    board, for the MITM board to come: module drawn as the real board with its
    sockets, one framed block per function, voltage domains split by a red
    barrier, wire colour code, LCSC on every part.
2026-11-10 docs: write the MITM firmware in Rust and tidy discovery/
    Decision: the MITM firmware is written in Rust on an ESP32-C3 rather than in
    ESPHome. The C3 has two full UARTs, one per channel, and esp-hal with embassy
    lets the board answer each poll from an interrupt within the next bit, with
    the frame logic tested on the computer. The ribbon power budget, measured with
    a D1 mini, is still to be confirmed with the C3.
    ESPHome now only drives the bench, so firmware/ is left to the Rust crate and
    discovery/ is sorted by kind: stage firmwares in their folders, shared ESPHome
    packages and linap-frames.h in esphome/, the KiCad bench and its generator in
    bench/, the Mac scripts in tools/. The three fi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
2026-11-10 feat(firmware): MITM in Rust on the ESP32-C3, linked to Home Assistant over MQTT
    - linap: pure no_std crate tested on the host (frames, parity, poll byte, relay
    or imposed state, last order wins, imposed Boost timeout, frame change filter)
    - mitm: both DATA halves served from their UART RX interrupts, Wi-Fi, MQTT
    device discovery, retained settings, frame log with notes
    - docs: firmware README, MQTT link and Boost timeout decided, backlog
2026-11-11 fix(firmware): get an IP on the C3 super mini and keep the state across restarts
    - Wi-Fi TX power raised to 11 dBm: at the 5 dBm default the board associates
    but never completes DHCP; second heap region as in the esp-hal example
    - state topic retained, published at once after the discovery
    - JSON field keys renamed keys_mode: Jinja read value_json.keys as dict.keys()
    - step logs for the MQTT session
2026-11-11 feat(hardware): MITM schematic, revision 1 for the breadboard
    - C3 super mini on two 1x8 sockets, one channel per board (divider on RX,
    2N3904 with base pull-down on TX), DATA pull-up on the power board side,
    470 uF bulk capacitor; LCSC part on every part but the ribbon connectors
    - generated by hardware/scripts/generate-schematic.py, ERC clean
    - KiCad helpers shared with the bench generator (output unchanged)
2026-11-11 feat(firmware): MITM owns the radiator state, USB console and OTA
    - one state, changed by the keys, Home Assistant and the USB console: the last order wins
    - off at 15 °C at start-up, the state retained on the broker restored when MQTT joins
    - each half plays its side on its own: the power board emulator no longer mirrors C7
    - answers counted when heard back whole
    - OTA pulled from firmware/tools/ota.py, partitions with two OTA slots
    - fallback Wi-Fi network, RX pull-up off for the high-impedance dividers
2026-11-11 feat(hardware): MITM schematic, revision 2 for the breadboard
    100 k / 150 k dividers so as not to load DATA, pull-up off on the C3.
2026-11-11 feat(discovery): C3 and USB variants of stage 2, sniffer for both sides of the MITM
2026-11-11 feat(firmware): ESPHome MITM on the Wemos D1 mini
    An ESPHome configuration with a C++ external component. The MITM owns the radiator's state (off, on at a
    setpoint, boost), saved in flash; the keys and Home Assistant change it, the last order wins. The power board
    side runs on UART0 swapped to D7/D8 with our own interrupt; the commander side transmits from the timer1 NMI
    on D6 and receives through remote_receiver on D5. The internal pull-up the core sets on D7 is cleared, or the
    divider never reaches a low level.
    Validated in loopback on the bench and on the radiator. Docs now describe the D1, ESPHome and the owned state.
2026-11-11 feat(hardware): MITM schematic revision 3 with the Wemos D1 mini
    The D1 mini replaces the ESP32-C3 super mini: power board side on D7/D8, commander side on D5/D6. Its symbol
    moves to hardware/scripts/modules.py, shared with the bench schematic.
